brockventures/gotchi/cad/renders/back_iso.png

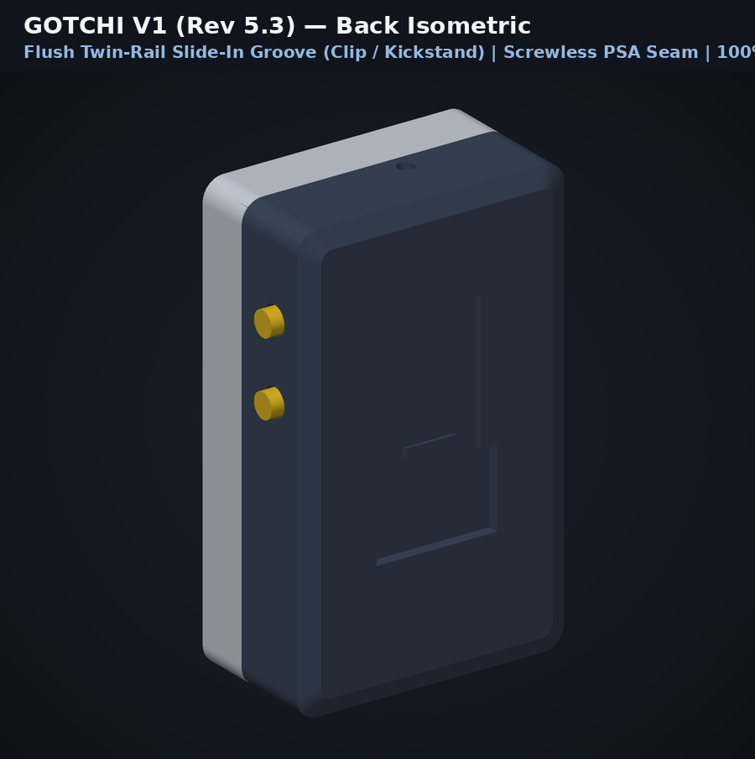
cad/renders/back_iso.png
