brockventures/gotchi/cad/renders/back_layout.png

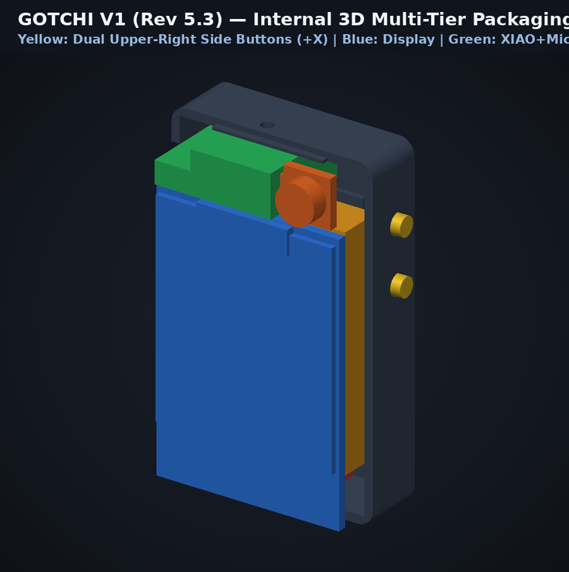
cad/renders/back_layout.png
