brockventures/gotchi/cad/renders/exploded.png

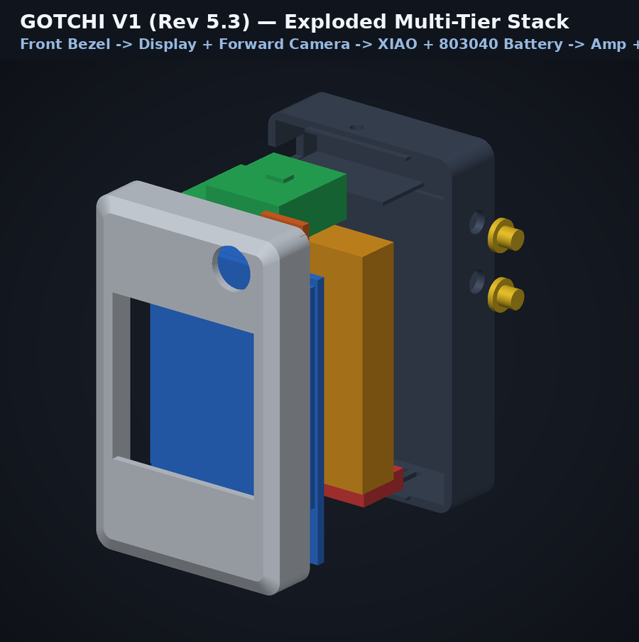
cad/renders/exploded.png
