brockventures/gotchi/cad/renders/front_iso.png

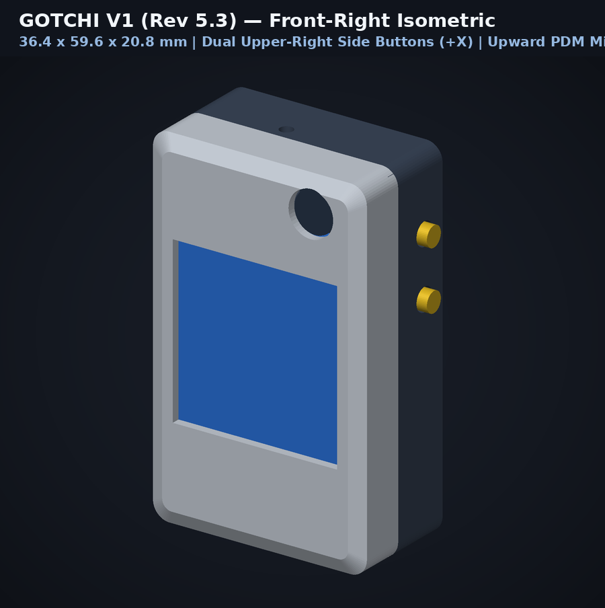
cad/renders/front_iso.png
