brockventures/gotchi/cad/renders/front_straight.png

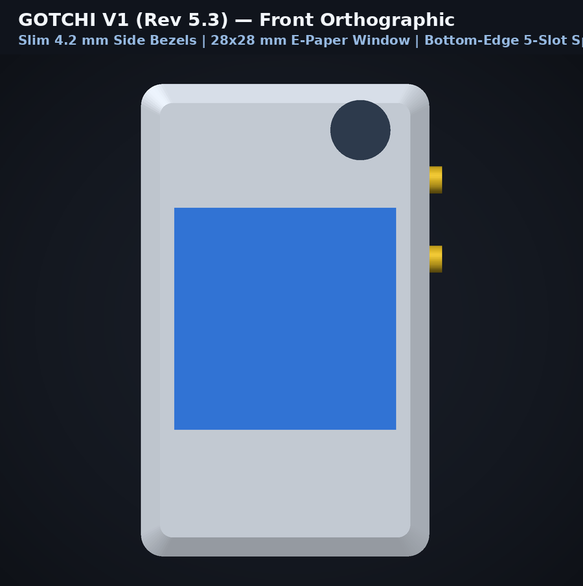
cad/renders/front_straight.png
