brockventures/gotchi/cad/renders/side_labeled.png

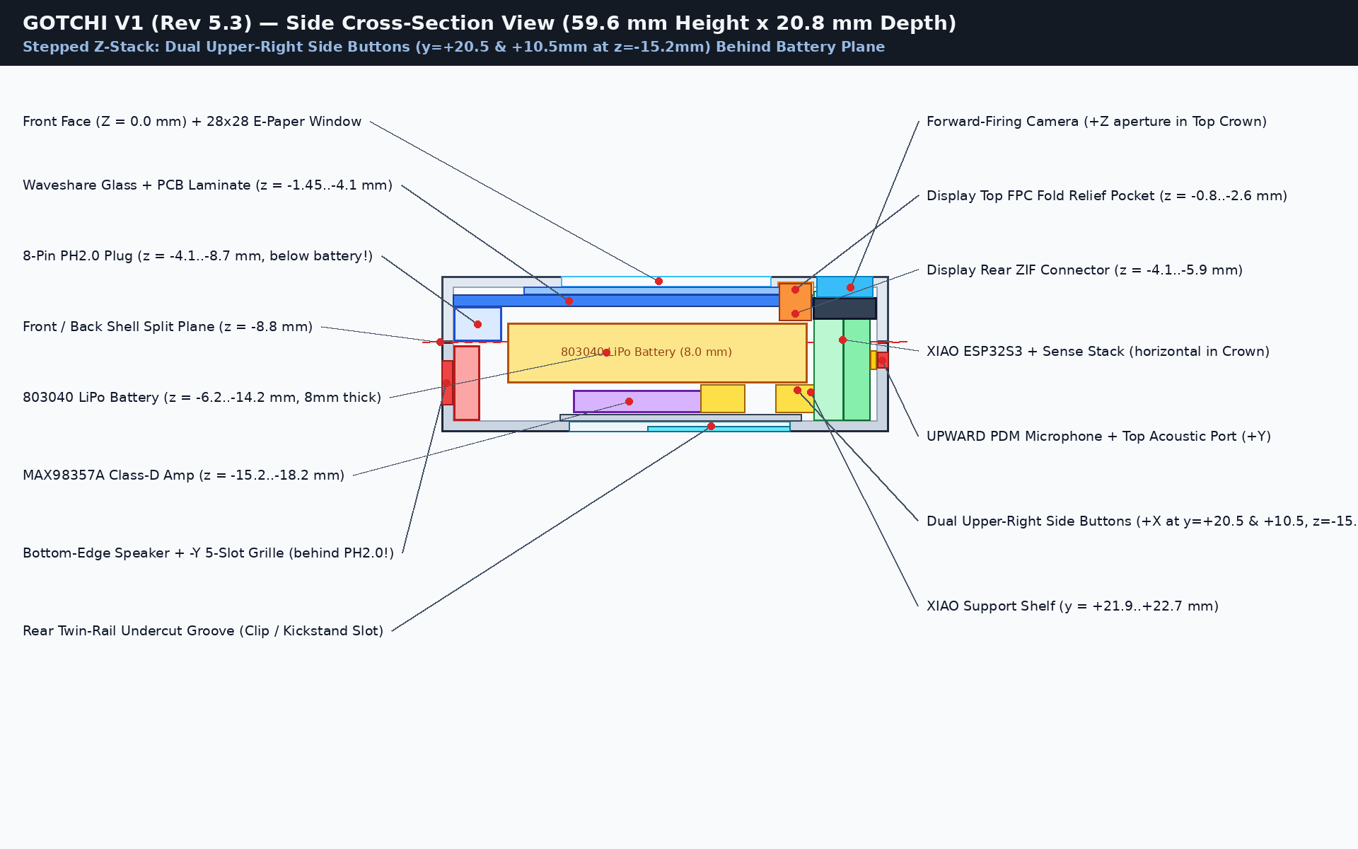
cad/renders/side_labeled.png
