brockventures/gotchi/cad/renders/top_labeled.png

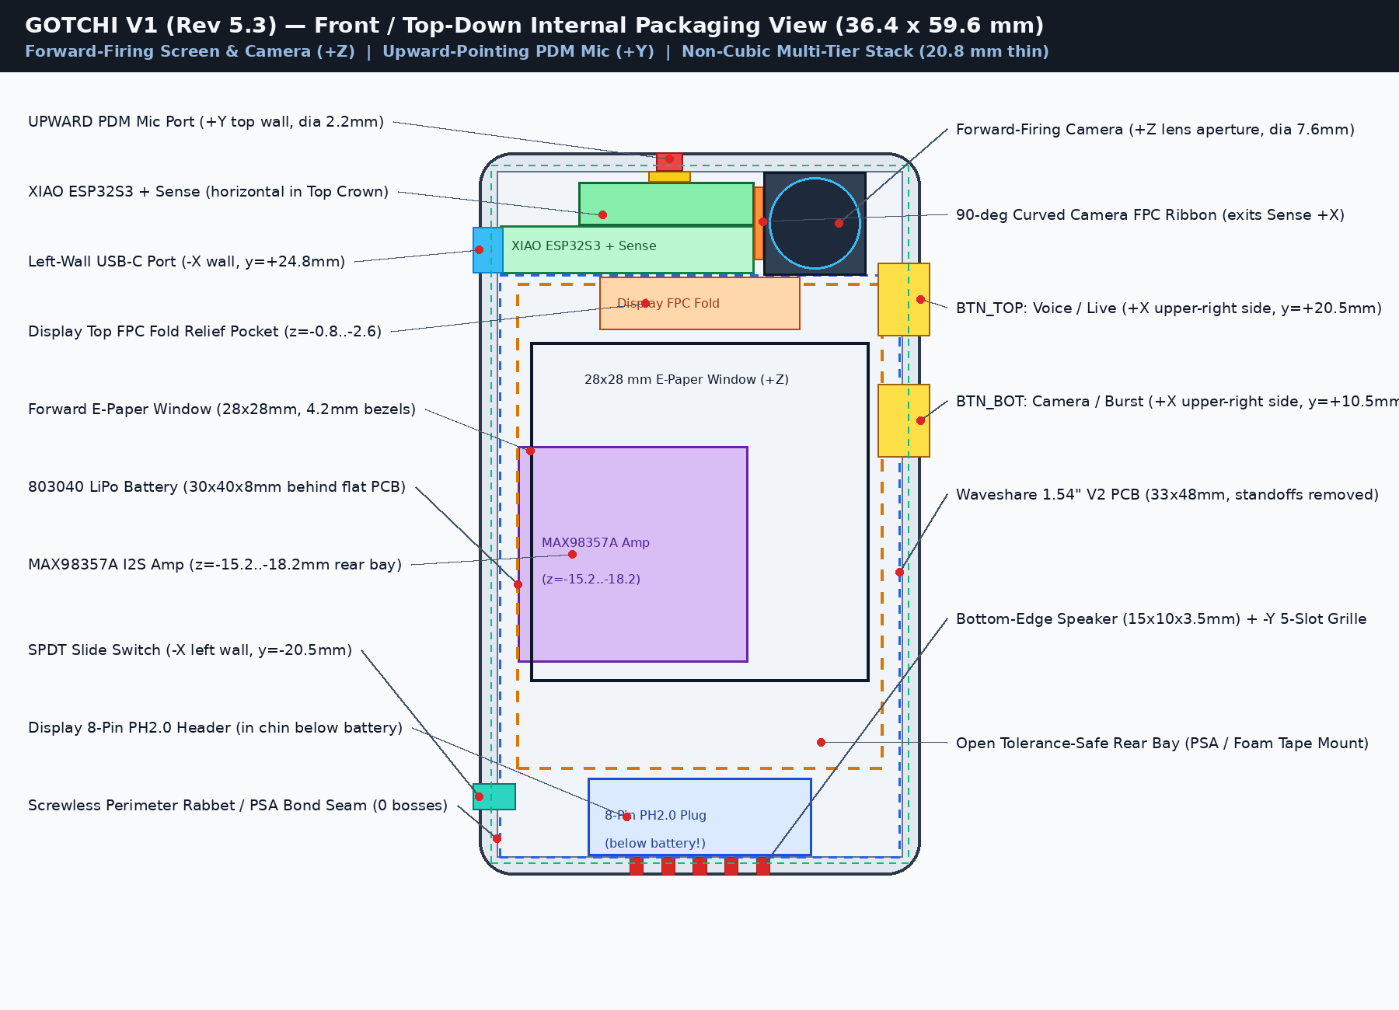
cad/renders/top_labeled.png
