brockventures/gotchi/cad/stl/gotchi_front.stl

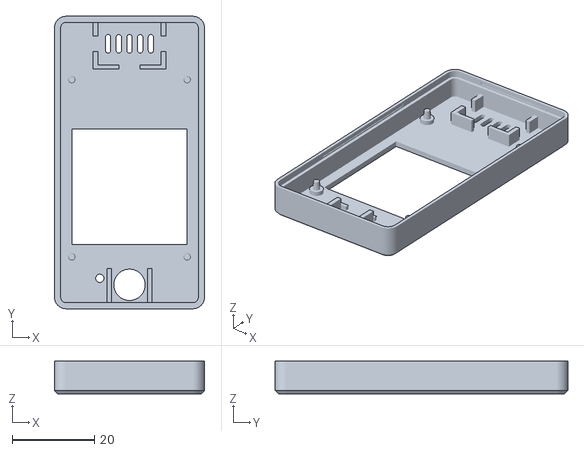
[picture p8: CAD file, 2026-10-24]
cad/stl/gotchi_front.stl
36.4 x 71.0 x 8.00
