brockventures/gotchi/cad/stl/gotchi_hinge_saddle.stl

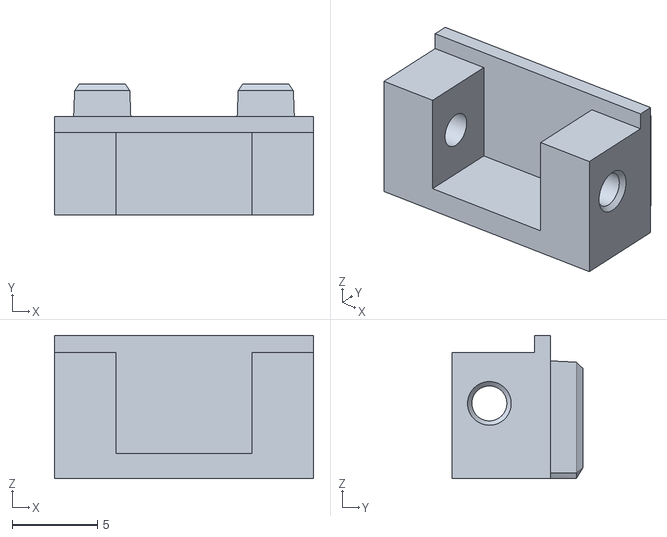
[picture p9: CAD file, 2026-10-24]
cad/stl/gotchi_hinge_saddle.stl
15.2 x 7.70 x 8.42
