brockventures/gotchi/cad/stl/gotchi_clip_stand.stl

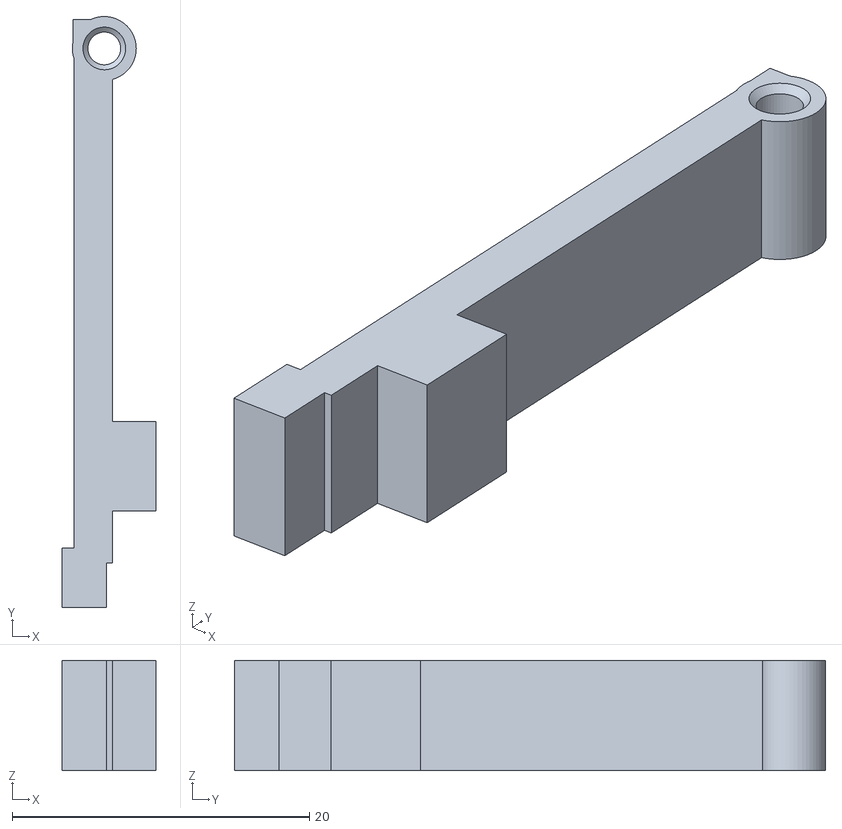
[picture p10: CAD file, 2026-10-24]
cad/stl/gotchi_clip_stand.stl
6.33 x 39.8 x 7.40
