brockventures/gotchi/cad/stl/gotchi_back.stl

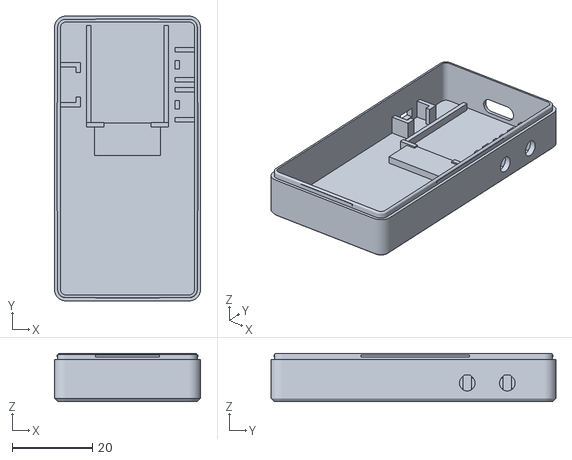
[picture p11: CAD file, 2026-10-24]
cad/stl/gotchi_back.stl
36.4 x 71.0 x 12.0
