brockventures/gotchi/cad/stl/gotchi_clip.stl

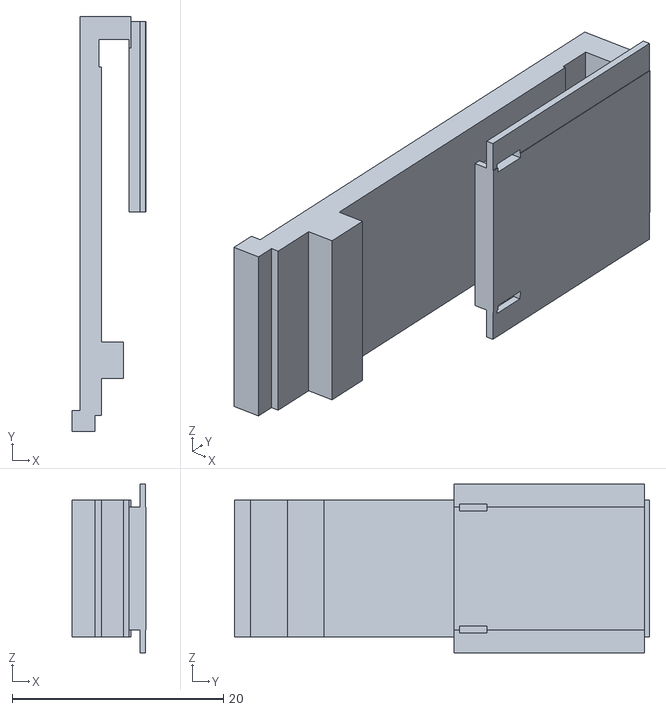
[picture p12: CAD file, 2026-10-23]
cad/stl/gotchi_clip.stl
7.05 x 39.3 x 16.0
