brockventures/gotchi/cad/stl/gotchi_kickstand.stl

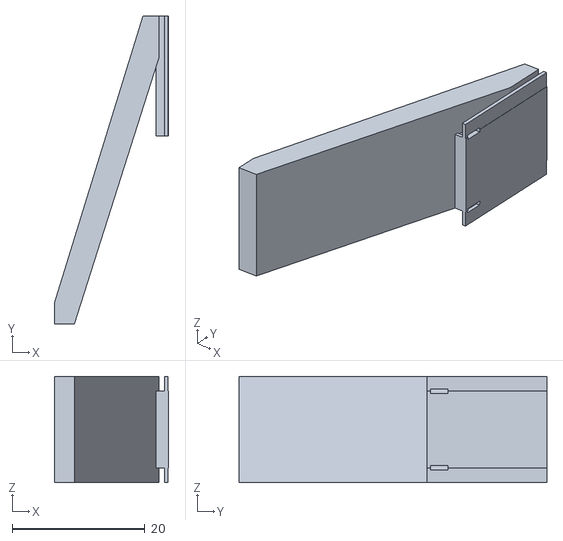
[picture p13: CAD file, 2026-10-23]
cad/stl/gotchi_kickstand.stl
17.1 x 46.3 x 16.0
