brockventures/gotchi/cad/stl/gotchi_button_cap.stl

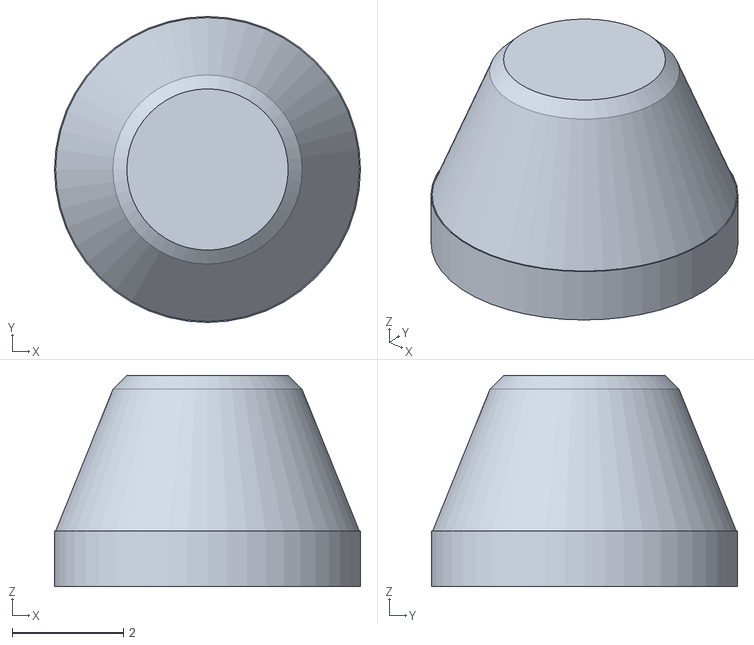
[picture p14: CAD file, 2026-10-23]
cad/stl/gotchi_button_cap.stl
5.50 x 5.50 x 3.80
