brockventures/gotchi/docs/HARDWARE_ASSEMBLY.md

# GOTCHI / SPRITE — Meatspace Hardware Assembly, Pinout & Enclosure Envelope

This document contains the complete physical wiring instructions, GPIO pin multiplexing map, mechanical component dimensions for the multi-part 3D-printed enclosure, and bench bring-up checklist for assembling a V1 GOTCHI unit from the locked 7-item BOM ([`docs/BOM.md`](BOM.md)).

---

## 1. Master GPIO Pinout & Bus Allocation Map

The **XIAO ESP32S3 Sense** uses internal GPIOs (`GPIO10–18`, `38–42`, `47–48`) for its B2B camera and PDM microphone daughterboard, leaving **11 perimeter pins (`D0–D10`)** exposed on the main headers.

The **Waveshare 1.54" E-Paper Module V2 (`SKU 12955` / Amazon `B0728BJTZC`)** includes an **8-pin PH2.0 wire harness** (`VCC`, `GND`, `DIN`, `CLK`, `CS`, `DC`, `RST`, `BUSY`) that wires directly to 6 XIAO perimeter pins plus `3V3`/`GND` (replacing the discontinued Seeed ePaper Breakout), leaving **5 perimeter pins (`D2`, `D4`, `D6`, `D7`, `D9`)** free for I2S audio, tactile buttons, and V2 expansion.

### Complete Pin Allocation Table

| XIAO Pin | ESP32-S3 GPIO | RTC / Deep-Sleep Wake? | V1 Assigned Function | Hardware Connection (Direct Harness / Wire) |
| :--- | :--- | :--- | :--- | :--- |
| **`D0`** | `GPIO 1` | Yes (`RTC_GPIO1`) | **ePaper `RST`** (Reset) | Waveshare 8-pin PH2.0 Harness **`RST`** |
| **`D1`** | `GPIO 2` | Yes (`RTC_GPIO2`) | **ePaper `CS`** (SPI Chip Select) | Waveshare 8-pin PH2.0 Harness **`CS`** |
| **`D2`** | `GPIO 3` | **Yes (`RTC_GPIO3` / `ADC1_CH2`)** | **BTN_TOP (PTT & Wake) + `5V VBUS` Sense** | Momentary `6x6x5mm` switch to `GND` + single `220 kΩ` series resistor from `5V` (`VBUS`) |
| **`D3`** | `GPIO 4` | Yes (`RTC_GPIO4`) | **ePaper `DC`** (Data/Command) | Waveshare 8-pin PH2.0 Harness **`DC`** |
| **`D4`** | `GPIO 5` | **Yes (`RTC_GPIO5` / `ADC1_CH4`)** | **BTN_BOT (Camera Snap) + `VBAT` Fuel Gauge** | Momentary `6x6x5mm` switch to `GND` + `220 kΩ / 220 kΩ` divider from switched `BAT+` to `GND` |
| **`D5`** | `GPIO 6` | Yes (`RTC_GPIO6`) | **ePaper `BUSY`** *(+ V2 `I2C_SCL`)* | Waveshare 8-pin PH2.0 Harness **`BUSY`** |
| **`D6`** | `GPIO 43` | No | **I2S `LRCLK`** (Audio Word Select) | Wire to `MAX98357A` **`LRC`** pin *(UART0 TX at reset)* |
| **`D7`** | `GPIO 44` | No | **I2S `BCLK`** (Audio Bit Clock) | Wire to `MAX98357A` **`BCLK`** pin *(UART0 RX — silent at reset)* |
| **`D8`** | `GPIO 7` | No | **ePaper `SCK`** (SPI Clock) | Waveshare 8-pin PH2.0 Harness **`CLK`** |
| **`D9`** | `GPIO 8` | No | **I2S `DIN`** (Audio Data Out) | Wire to `MAX98357A` **`DIN`** pin *(MISO unused by ePaper)* |
| **`D10`** | `GPIO 9` | No | **ePaper `MOSI`** (SPI Data Out) | Waveshare 8-pin PH2.0 Harness **`DIN`** |
| **`3V3`** | — | — | **3.3V Regulated Rail** | Waveshare 8-pin PH2.0 Harness **`VCC`** (+ optional `MAX98357A VIN`) |
| **`5V`** | — | — | **5V / VBUS Rail** | `MAX98357A VIN` + `220 kΩ` wall-brick sense resistor to `D2` |
| **`GND`** | — | — | **Common Ground** | Waveshare **`GND`**, `MAX98357A` **`GND`**, `BTN_TOP`, `BTN_BOT`, and divider ground legs |
| **`GPIO 0`** | `GPIO 0` | Yes (`RTC_GPIO0`) | **Reserved (`BOOT` Strapping Pad)** | Leave unattached in V1 so holding `BTN_BOT` at power-on never traps the MCU in ROM download mode |
| *Internal* | `GPIO 41` | — | **PDM Mic `CLK`** | Internal via Sense B2B Header |
| *Internal* | `GPIO 42` | — | **PDM Mic `DATA`** | Internal via Sense B2B Header |
| *Internal* | `GPIO 10–18, 38–40, 47–48` | — | **DVP Camera Bus (`OV2640`/`OV3660` or `OV5640`)** | Internal via Sense B2B Header |

> **Strapping & Boot-Glitch Protections (Amos + Zero Audit):**
> 1. **`BTN_BOT` Landed on `D4` (`GPIO 5`) Instead of `GPIO 0`:** `GPIO 0` is the ESP32-S3 ROM bootloader strapping pin. Landing `BTN_BOT` on `D4` (`GPIO 5` / `RTC_GPIO5`) eliminates the risk of entering USB download mode if the button is pressed in a pocket while flipping the power switch, and avoids micro-soldering to the tiny surface-mount `BOOT` pad.
> 2. **Pop-Free Boot on `MAX98357A` (`BCLK` on `D7` / `GPIO 44`):** `D6` (`GPIO 43`) is the ESP32-S3's default `UART0_TX`, which emits brief ROM boot messages at reset, whereas `D7` (`GPIO 44` / `UART0_RX`) is completely silent at boot. Routing **`BCLK` to `D7` (`GPIO 44`)** and **`LRCLK` to `D6` (`GPIO 43`)** ensures the `MAX98357A` sees zero valid bit-clock edges during ROM boot and stays muted until the I2S driver starts.
> 3. **`BTN_TOP` on `D2` (`GPIO 3` Strapping Note):** `GPIO 3` is an optional JTAG-source strapping pin (only evaluated when `EFUSE_STRAP_JTAG_SEL` is burned, which is disabled by default from the factory). Leave `EFUSE_STRAP_JTAG_SEL` unburned (`0`) so holding PTT at power-on has zero effect on USB serial/JTAG.

---

## 2. Step-by-Step Meatspace Assembly Instructions

### Step 1: Camera & Sense Expansion Board Check
1. **Stock V1 Baseline (No Swap Required):** The **XIAO ESP32S3 Sense** ships with its stock camera (`OV2640` / `OV3660`) pre-installed on the Sense expansion board alongside the digital PDM microphone. Stick the included mini heatsink onto the flat backing of the camera module and snap the Sense board onto the top B2B header of the XIAO.
2. **Optional `OV5640` 5MP Autofocus Upgrade (`$11.99`):** If installing the optional `OV5640` camera, unplug the Sense board from the XIAO first, flip up the black locking bail on the 24-pin FPC socket, swap in the `OV5640` ribbon (contacts facing the PCB), press the locking bail flat, and attach the heatsink.
3. Snap the included **U.FL Wi-Fi/BLE flex antenna (`~42 x 12 mm`)** onto the coaxial receptacle on the XIAO and adhere the flat antenna patch strictly along the **inner plastic perimeter wall** of the enclosure. **Never** stick the antenna onto the `803040` LiPo battery's aluminized foil pouch or the metallic rear shield of the Waveshare e-paper panel (which causes `6–12 dB` of near-field capacitive detuning), and keep the U.FL coax away from the speaker magnet and camera FPC ribbon.

### Step 2: Battery Pads & Hardware Power Switch (Bottom of XIAO)
> **SAFETY WARNING:** Never connect or solder the LiPo battery while USB-C is plugged in. Always verify wire polarity (`red = BAT+`, `black = BAT-`) before soldering, and insulate all exposed joints with Kapton tape.

1. Cut the factory 2-pin JST plug off the **`803040` 3.7V 1000mAh LiPo battery (`B0FRFY7KLH`)** one lead at a time (never cut both wires simultaneously with metal cutters) and strip `~3 mm` of insulation.
2. Flip the main **XIAO ESP32-S3** board over to locate the two rectangular solder pads labeled **`BAT+`** and **`BAT-`** on the bottom surface, and tin both pads.
3. Solder the **black (`-`) battery lead** directly to the XIAO **`BAT-`** pad.
4. Solder the **red (`+`) battery lead** to the **center pin (common)** of the **Mini SPDT 3-Pin Slide Switch (`B0FNK8B1YV`)**.
5. Solder a short 30 AWG red wire from **one outer pin** of the slide switch to the XIAO **`BAT+`** pad. (Sliding the switch toward that outer pin turns the unit ON and enables USB-C LiPo charging; sliding it away completely disconnects the battery).
6. Apply a strip of **Kapton tape** over the bottom of the XIAO board to insulate the solder pads.

### Step 3: Wiring the Waveshare 1.54" E-Paper Module V2 (`SKU 12955` / `B0728BJTZC`)
Plug the included **8-pin PH2.0 connector** into the back of the Waveshare 1.54" E-Paper Module V2 PCB and solder/connect the 8 leads directly to the XIAO ESP32S3:
- **`VCC`** -> XIAO **`3V3`**
- **`GND`** -> XIAO **`GND`**
- **`DIN` (MOSI)** -> XIAO **`D10` (`GPIO 9`)**
- **`CLK` (SCK)** -> XIAO **`D8` (`GPIO 7`)**
- **`CS`** -> XIAO **`D1` (`GPIO 2`)**
- **`DC`** -> XIAO **`D3` (`GPIO 4`)**
- **`RST`** -> XIAO **`D0` (`GPIO 1`)**
- **`BUSY`** -> XIAO **`D5` (`GPIO 6`)**

### Step 4: Wiring the `MAX98357A` I2S Audio Amplifier (`B0DPJRLMDJ`) & Speaker (`B0D7S8FFKY`)
Wire the **`MAX98357A`** breakout to the XIAO with 30 AWG silicone wire:
- **`MAX98357A VIN`** -> XIAO **`5V`** (or **`3V3`** for lower peak battery current)
- **`MAX98357A GND`** -> XIAO **`GND`**
- **`MAX98357A BCLK`** -> XIAO **`D7` (`GPIO 44`)** *(Silent `UART0_RX` at boot — prevents ROM serial boot pop)*
- **`MAX98357A LRC`** -> XIAO **`D6` (`GPIO 43`)**
- **`MAX98357A DIN`** -> XIAO **`D9` (`GPIO 8`)**
- **`MAX98357A SD` (Shutdown)** -> Leave floating (internal pull-up keeps amp enabled in mono `(L+R)/2` mode; automatically enters `<1 µA` hardware shutdown whenever the ESP32-S3 stops the I2S clock).
- Connect or solder the **1W 8Ω Mini Cavity Speaker (`B0D7S8FFKY`)** leads to the `+` and `-` audio output terminals on the `MAX98357A`. **Twist the `+` and `-` speaker wires into a tight twisted pair (`~2–3 twists/cm`)** and trim lead length to **`<= 40–50 mm`** so the `MAX98357A`'s filterless Class-D switching edges (`~300 kHz`) cancel out rather than radiating broadband harmonics into the 2.4 GHz antenna.

### Step 5: Wiring the Tactile Push Buttons (`6x6x5mm`, `B07VSNN9S2`)
1. **Top Button (`BTN_TOP` — Push-to-Talk & Deep-Sleep Wake):**
   - Wire Pin 1 of the tactile switch to XIAO **`D2` (`GPIO 3` / `RTC_GPIO3`)**.
   - Wire Pin 2 of the tactile switch to **`GND`**.
2. **Bottom Button (`BTN_BOT` — Camera Snap / 5-Frame Burst):**
   - Wire Pin 1 of the tactile switch directly to XIAO **`D4` (`GPIO 5` / `RTC_GPIO5`)**. *(Never wire to `GPIO 0`).*
   - Wire Pin 2 of the tactile switch to **`GND`**.

### Step 6: Wiring the V1 Battery Fuel Gauge (`D4`) & Wall-Brick Power Sense (`D2`) (3x `220 kΩ` Resistors)
Because the XIAO ESP32S3 does not route `VBUS` (`5V`) or `BAT+` internally to any GPIO, V1 uses **3x `220 kΩ` (`1/4W 1%`) resistors** (all three are the exact same `220 kΩ` value) sleeved in heat-shrink tubing to multiplex battery voltage and wall-brick detection onto `D4` and `D2`:

1. **LiPo Battery Fuel Gauge Divider on `D4` (`GPIO 5` / `ADC1_CH4` — 2x `220 kΩ`):**
   - Solder one **`220 kΩ` resistor** between the switched **`BAT+` outer terminal** on the SPDT power switch and XIAO **`D4`**.
   - Solder a second **`220 kΩ` resistor** between XIAO **`D4`** and **`GND`** (you can solder it directly across the two legs of `BTN_BOT`).
   - *How it works:* Normal operation keeps `D4`'s internal `45 kΩ` pull-up enabled so `D4` idles at `>= 2.82 V` (`> 2.475 V` `V_IH_min`). Once per second when idle, firmware takes a `200 µs` high-Z ADC sample (`V_BAT / 2` = `1.65V–2.10V` for a `3.30V–4.20V` LiPo, drawing `<9 µA` when switched ON and `0 µA` when switched OFF) to compute `0–100%` battery state-of-charge.
2. **Wall-Brick (`5V VBUS`) Sense on `D2` (`GPIO 3` / `ADC1_CH2` — 1x `220 kΩ`):**
   - Solder the third **`220 kΩ` resistor** between XIAO **`5V`** (`VBUS`) and XIAO **`D2`** *(no external ground resistor is used on `D2`)*.
   - *How it works:* During normal operation (`INPUT_PULLUP` `45 kΩ` to `3.3V`), even if the `5V` rail is pulled to `0V` by the `MAX98357A` load when running on battery, `D2` idles at `3.3V × 220 / (45 + 220) = 2.74 V` (or `3.30 V` if `5V` floats) — safely above the ESP32-S3's `2.475 V` (`0.75 × VDD`) `V_IH` minimum so `BTN_TOP` digital reads and `ext0` deep-sleep wake work reliably. Once per second when idle, firmware briefly enables `INPUT_PULLDOWN` (`45 kΩ` to `GND`) for `200 µs`: when a 5V USB-C wall brick or computer is plugged in, `D2` reads `5.0V × 45 / (220 + 45) ≈ 849 mV` (`>= 450 mV` threshold) vs. `0 mV` on battery, enabling `preroll_mode: "usb_host"` and the on-screen charging indicator (`+`).

### Step 7: RF Desense & Internal Harness Routing Rules (2.4 GHz Wi-Fi / BLE)
Inside the compact `54 × 44 mm` enclosure, follow these three physical routing rules to prevent 2.4 GHz receiver desense and near-field antenna detuning:
1. **LiPo Foil & E-Paper Shield Keep-Out (`6–12 dB` Detuning Prevention):**
   - Adhere the `42 × 12 mm` U.FL flex antenna patch flat against the **outer PLA/PETG perimeter wall** with **`>= 5 mm` air gap** from both the `803040` LiPo battery's aluminized pouch and the metallic rear shield of the Waveshare 1.54" e-paper module. Never fold, crease, or trim the copper radiating element.
2. **Twisted-Pair Filterless Class-D Speaker Leads (`MAX98357A` EMI Suppression):**
   - Because the `MAX98357A` uses a filterless Class-D H-bridge (`~300 kHz` PWM with fast rising/falling edges), keep the speaker leads **`<= 40–50 mm`** and twisted at **`~2–3 twists/cm`** all the way from the amp terminals to the `1510` speaker cavity.
3. **High-Speed Digital Bus Separation (`I2S`, `SPI`, and `20 MHz` Camera `XCLK`):**
   - Dress the thin coaxial lead from the XIAO U.FL jack along the opposite edge of the board from the `D6/D7/D9` I2S clock bundle (`BCLK`/`LRCLK`), the `D8/D10` e-paper SPI harness, and the 24-pin camera FPC ribbon (`20 MHz XCLK` / PCLK).

---

## 3. Mechanical Component Envelope (For Multi-Part Blender / CAD Case)

Reference dimensions for the locked 7-item V1 BOM (`cad/` multi-part openable shell):

| # | Component | Nominal Dimensions (`L x W x H`) | Enclosure Cutout & Mounting Notes |
| :--- | :--- | :--- | :--- |
| **1** | **XIAO ESP32S3 + Sense Stack** | `21.0 x 17.8 x ~15.0 mm` | `USB-C` receptacle (`9.0 x 3.4 mm` opening) on bottom edge; top-port MEMS PDM mic sits on the top face of the Sense expansion board adjacent to the camera FPC header (faces the same direction as the camera lens, so a `Ø 2.0 mm` pinhole next to the `~8.5 x 8.5 mm` camera cutout or a shared relief channel works cleanly); `U.FL` flex antenna patch (`~42 x 12 mm`). |
| **2** | **Waveshare 1.54" E-Paper V2 (`SKU 12955`)** | **`48.0 x 33.0 x ~2.8 mm`** *(+ `~5.5 mm` rear PH2.0 header)* | Active viewing bezel opening: **`27.6 x 27.6 mm`** (`200x200` px). 4x **`M2` (`Ø 2.0 mm`)** corner mounting holes (`~43.0 x 28.0 mm` hole centers). |
| **3** | **MAX98357A I2S Amp (`B0DPJRLMDJ`)** | `~19.0 x 17.8 x 3.0 mm` | Internal tray or siderib slot; 2x `M2` mounting holes. |
| **4** | **1W 8Ω Cavity Speaker (`B0D7S8FFKY`)** | **`15.0 x 10.0 x 3.5 mm`** (`1510` cavity, allow `16.0 x 11.0 x 4.5 mm` pocket) | Enclosed resonant micro-speaker w/ JST-PH1.25 leads; place sound grille slots facing outward. |
| **5** | **`803040` 1000mAh LiPo (`B0FRFY7KLH`)** | **`40.0 x 30.0 x 8.0 mm`** *(design bay **`42.0 x 32.0 x 9.0 mm`**)* | Flat rear compartment in the back shell half with `1.0 mm` swell clearance and wire exit channel. |
| **6** | **2x Tactile Buttons (`B07VSNN9S2`)** | `6.0 x 6.0 x 5.0 mm` (`3.5 mm` base + `1.5 mm` stem) | Side-edge cradle for `BTN_TOP` (PTT) and `BTN_BOT` (Mode/Snap) with captive button caps or compliant flex paddles. |
| **7** | **Mini SPDT Slide Switch (`B0FNK8B1YV`)** | `~8.5 x 3.5 x 4.0 mm` (`2.0 mm` slider travel) | Recessed perimeter slot (`~4.5 x 2.0 mm` window) so the power switch cannot flip accidentally in a pocket. |

---

## 4. First-Power & Smoke-Test Checklist

1. **Continuity & Short Check:** With the power switch **OFF** and USB-C unplugged, use a multimeter to verify there is no short between `3V3` and `GND` or `5V` and `GND`.
2. **USB-C Bring-Up:** Plug a USB-C data cable into your workstation, flip the slide switch **ON**, and verify `/dev/ttyACM0` (Linux) or `/dev/cu.usbmodem*` (macOS) enumerates.
3. **Automated Hardware & RF Desense Self-Test:** Once V1 firmware is flashed, send `{"cmd": "self_test"}` over USB serial (`115200` baud) or HTTP (`POST /api/rpc`) and confirm all subsystems and RF checks pass:
   - `speaker`: Plays an 880 Hz test tone on the `MAX98357A`.
   - `mic`: Samples non-zero RMS audio energy on the PDM mic (`GPIO41`/`42`).
   - `camera`: Initializes the stock `OV2640`/`OV3660` (or optional `OV5640` AF) camera (`camera_pid != 0`) and captures a valid test JPEG frame (`camera_frame_bytes > 0`).
   - `display`: Verifies `epd_busy_clear: true` and renders the 200x200 sprite on the Waveshare 1.54" V2 e-paper panel.
   - `wifi_rssi_dbm` (`wifi_rssi_idle_dbm` vs. `wifi_rssi_active_dbm`): Measures baseline idle 2.4 GHz Wi-Fi RSSI against active RSSI sampled while the `MAX98357A` Class-D speaker tone and camera DVP capture run simultaneously. Confirm **`wifi_rssi_drop_db <= 2` (`rf_desense_warn: false`)**. If `wifi_rssi_drop_db > 2 dB`, move the U.FL flex antenna further from the LiPo/e-paper shield or tighten the speaker wire twist before closing the case.
