brockventures/gotchi/cad/renders/v3_build_preview.png

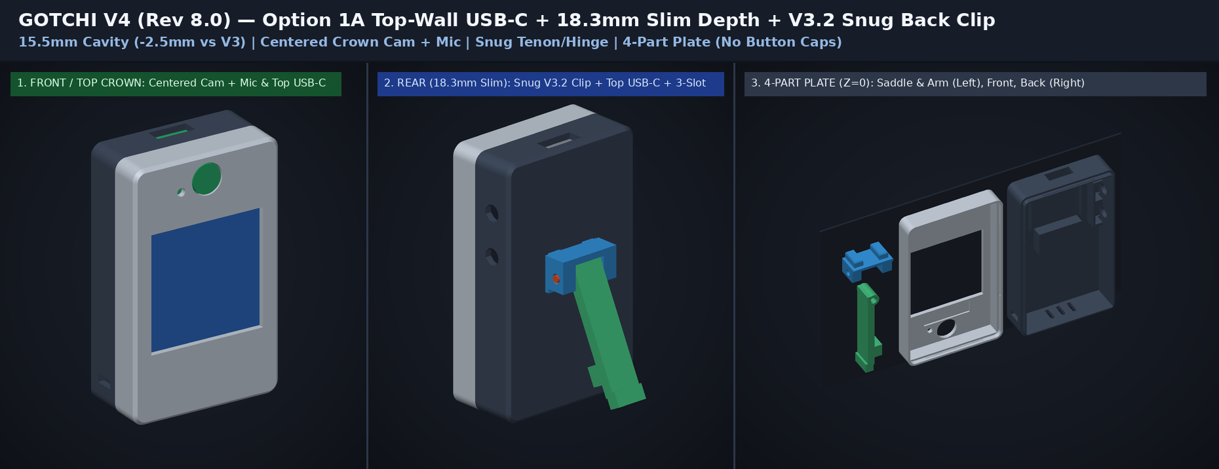
cad/renders/v3_build_preview.png
