brockventures/gotchi/firmware/include/zero_skin_bitmap.h

#pragma once
#include <Arduino.h>
#include <pgmspace.h>

// 196x134 1-bit Atkinson-dithered Zero portraits (bit=1 is WHITE pixel on BLACK background)
static constexpr int ZERO_PORTRAIT_W = 196;
static constexpr int ZERO_PORTRAIT_H = 134;

const uint8_t ZERO_IDLE_PORTRAIT_196x134[] PROGMEM = {
    0x00, 0x00, 0x00, 0x00, 0x00, 0x00, 0x00, 0x00, 0x00, 0x00, 0x00, 0x12, 0x49, 0x24, 0x84, 0x00, 0x00, 0x00, 0x00, 0x00, 0x00, 0x00, 0x00, 0x00, 0x00, 0x00, 0x00, 0x00, 0x00, 0x00, 0x00, 0x00, 0x00, 0x00, 0x09, 0x36, 0xc9, 0x66, 0xd9, 0x33, 0x6c, 0x90, 0x00, 0x00, 0x00, 0x00, 0x00, 0x00, 0x00, 0x00, 0x00, 0x00, 0x00, 0x00, 0x00, 0x00, 0x00, 0x00, 0x09, 0x24, 0xc4, 0xbf, 0xff, 0xff, 0xf9, 0x22, 0x46, 0x48, 0x00, 0x00, 0x00, 0x00, 0x00, 0x00, 0x00, 0x00, 0x00, 0x00, 0x00, 0x00, 0x00, 0x00, 0x01, 0x21, 0x26, 0x5b, 0xff, 0xff, 0xff, 0xff, 0xdb, 0x48, 0x82, 0x00, 0x00, 0x00, 0x00, 0x00, 0x00, 0x00, 0x00, 0x00, 0x00, 0x00, 0x00, 0x00, 0x00, 0x08, 0x04, 0x99, 0x7f, 0xfe, 0x40, 0x02, 0xff, 0xfd, 0x32, 0x30, 0x90, 0x00, 0x00, 0x00, 0x00, 0x00, 0x00, 0x00, 0x00, 0x00, 0x00, 0x00, 0x00, 0x00, 0x42, 0x52, 0x4d, 0xff, 0x00, 0x00, 0x00, 0x00, 0xff, 0xed, 0x84, 0x04, 0x00, 0x00, 0x00, 0x00, 0x00, 0x00, 0x00, 0x00, 0x00, 0x00, 0x00, 0x00, 0x01, 0x10, 0x4b, 0x7f, 0xe0, 0x00, 0x00, 0x00, 0x00, 0x07, 0xfc, 0xd3, 0x21, 0x00, 0x00, 0x00, 0x00, 0x00, 0x00, 0x00, 0x00, 0x00, 0x00, 0x00, 0x00, 0x04, 0x05, 0x29, 0xff, 0x00, 0x01, 0xff, 0xfe, 0x00, 0x00, 0x7f, 0x98, 0x88, 0x40, 0x00, 0x00, 0x00, 0x00, 0x00, 0x00, 0x00, 0x00, 0x00, 0x00, 0x00, 0x10, 0x41, 0x27, 0xf0, 0x00, 0xff, 0xff, 0xff, 0xff, 0x00, 0x07, 0xf6, 0x42, 0x10, 0x00, 0x00, 0x00, 0x00, 0x00, 0x00, 0x00, 0x00, 0x00, 0x00, 0x00, 0x41, 0x19, 0xbf, 0x80, 0x0f, 0xff, 0xff, 0xff, 0xff, 0xf8, 0x00, 0xfd, 0x50, 0x84, 0x00, 0x00, 0x00, 0x00, 0x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
};

const uint8_t ZERO_BASE_PORTRAIT_196x134[] PROGMEM = {
    0x00, 0x00, 0x00, 0x00, 0x00, 0x00, 0x00, 0x00, 0x00, 0x00, 0x00, 0x12, 0x49, 0x24, 0x84, 0x00, 0x00, 0x00, 0x00, 0x00, 0x00, 0x00, 0x00, 0x00, 0x00, 0x00, 0x00, 0x00, 0x00, 0x00, 0x00, 0x00, 0x00, 0x00, 0x09, 0x36, 0xc9, 0x66, 0xd9, 0x33, 0x6c, 0x90, 0x00, 0x00, 0x00, 0x00, 0x00, 0x00, 0x00, 0x00, 0x00, 0x00, 0x00, 0x00, 0x00, 0x00, 0x00, 0x00, 0x09, 0x24, 0xc4, 0xbf, 0xff, 0xff, 0xf9, 0x22, 0x46, 0x48, 0x00, 0x00, 0x00, 0x00, 0x00, 0x00, 0x00, 0x00, 0x00, 0x00, 0x00, 0x00, 0x00, 0x00, 0x01, 0x21, 0x26, 0x5b, 0xff, 0xff, 0xff, 0xff, 0xdb, 0x48, 0x82, 0x00, 0x00, 0x00, 0x00, 0x00, 0x00, 0x00, 0x00, 0x00, 0x00, 0x00, 0x00, 0x00, 0x00, 0x08, 0x04, 0x99, 0x7f, 0xfe, 0x40, 0x02, 0xff, 0xfd, 0x32, 0x30, 0x90, 0x00, 0x00, 0x00, 0x00, 0x00, 0x00, 0x00, 0x00, 0x00, 0x00, 0x00, 0x00, 0x00, 0x42, 0x52, 0x4d, 0xff, 0x00, 0x00, 0x00, 0x00, 0xff, 0xed, 0x84, 0x04, 0x00, 0x00, 0x00, 0x00, 0x00, 0x00, 0x00, 0x00, 0x00, 0x00, 0x00, 0x00, 0x01, 0x10, 0x4b, 0x7f, 0xe0, 0x00, 0x00, 0x00, 0x00, 0x07, 0xfc, 0xd3, 0x21, 0x00, 0x00, 0x00, 0x00, 0x00, 0x00, 0x00, 0x00, 0x00, 0x00, 0x00, 0x00, 0x04, 0x05, 0x29, 0xff, 0x00, 0x01, 0xff, 0xfe, 0x00, 0x00, 0x7f, 0x98, 0x88, 0x40, 0x00, 0x00, 0x00, 0x00, 0x00, 0x00, 0x00, 0x00, 0x00, 0x00, 0x00, 0x10, 0x41, 0x27, 0xf0, 0x00, 0xff, 0xff, 0xff, 0xff, 0x00, 0x07, 0xf6, 0x42, 0x10, 0x00, 0x00, 0x00, 0x00, 0x00, 0x00, 0x00, 0x00, 0x00, 0x00, 0x00, 0x41, 0x19, 0xbf, 0x80, 0x0f, 0xff, 0xff, 0xff, 0xff, 0xf8, 0x00, 0xfd, 0x50, 0x84, 0x00, 0x00, 0x00, 0x00, 0x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
};
