brockventures/gotchi/(commit log)

2026-10-18 Initial commit: GOTCHI / SPRITE architecture, BOM, and agent-configurable spec
2026-10-18 Separate decided baseline from open proposals; restore BLE phone relay & drop unagreed 1-bit lock
2026-10-18 Keep shared phone internet requirement in baseline; move BLE relay vs hotspot mechanics to open proposals
2026-10-19 Add locked V1 BOM, meatspace hardware assembly guide, architecture spec, software task board, and updated README/AGENTS.md
2026-10-19 docs(bom): update BOM with live verified Seeed + Amazon prices and drop discontinued ePaper breakout
2026-10-19 docs(bom): lock 1-unit per-builder live BOM, verify B0728BJTZC=SKU 12955, and remove Seeed breakout
2026-10-19 docs: sync all repo specs to locked 7-item V1 BOM and add mechanical case dimensions
2026-10-19 docs(assembly): update B0D7S8FFKY speaker to 15x10x3.5mm and note Sense PDM mic face
2026-10-19 cad: V1 two-part printable case (Blender script, STLs, renders)
    Parametric Blender 4.0.2 script that builds the front half, back half and
    button cap from one parameter dict, then exports print-oriented STLs, a
    .blend of the assembled design and three Cycles previews.
    Run headless: blender -b --python cad/build_case.py -- --out cad
    Notes on solver/tessellation choices (no parameter values changed):
    - cylinders rotated half a segment to avoid tangent contact with walls
    - boss top embedded 0.01 mm into front wall (coplanar face gave NM edges)
    - each hole cutter is its own boolean (combined operand corrupted front)
    [gotchi_back.stl, gotchi_button_cap.stl, gotchi_case.blend, gotchi_front.stl]
2026-10-19 docs(agents): point cad/ layout entry at V1 case README and run command
    Also ignore Blender's cad/*.blend1 backup written on re-runs.
2026-10-19 cad: exploded view moves only the back half; three part lines
    - exploded.png: placeholders stay at assembled coordinates; only the back
    half moves -35 Z. Camera moved below the front rim so placeholders are
    not occluded.
    - build_case.py: drop the duplicate (print) lines so the run prints exactly
    three part lines. Print copies are rigid transforms, so the check is
    unchanged.
    - README: cylinder half-segment rotation described as pre-emptive, not
    shown necessary. Combined-hole defect described as observed, cause not
    isolated.
    [gotchi_case.blend]
2026-10-19 cad: V1 case rev 2, 9.0 mm display bay and PDM mic port
    - disp_d 7.0 -> 9.0; front half z 0..-11, back half z -11..-29 (D_out 29.0)
    - btn_cz and sw_cz -16 -> -18 so buttons, sockets and switch keep their place
    - Back-half z values shift -2.0; pilot holes measured 6.0 from z=-11
    - Mic port: own boolean cutter, d 2.0 at (6.0, -24.0), through back wall only
    - Regenerated STLs, gotchi_case.blend and renders
    Parts: front 38x72x11 nonmanifold=0; back 38x72x18 nonmanifold=0;
    button_cap 5.49x5.49x4.00 nonmanifold=0.
    [gotchi_back.stl, gotchi_case.blend, gotchi_front.stl]
2026-10-19 cad: README for rev 2 (params, collisions, fit-test items)
2026-10-19 cad rev 3: XIAO behind the display, USB-C slot in back half, flat split rim, readable renders
    [gotchi_back.stl, gotchi_case.blend, gotchi_front.stl]
2026-10-19 cad: labelled top-down and side section views
2026-10-19 feat(cad): Rev 4 slim forward-firing multi-tier case (36.4x60.2x20.8mm, upward mic, non-cubic 3D stack)
    [gotchi_back.stl, gotchi_button_cap.stl, gotchi_case.blend, gotchi_front.stl]
2026-10-19 fix(cad): replace matplotlib Painter's algorithm with true per-pixel Z-buffer 2x SSAA renderer
2026-10-19 feat(cad): add flush rear twin-rail slide-in groove + spring clip & 20-deg kickstand STLs (Rev 4.1)
    [gotchi_back.stl, gotchi_clip.stl, gotchi_kickstand.stl]
2026-10-19 feat(software): scaffold ESP32-S3 firmware, 200x200 e-paper sprite engine & Pi Zero W POC harness
    [partitions_8mb_ota.csv]
2026-10-19 feat(firmware): e-paper renderer and refresh policy (T2.6)
    Port poc/gotchi_poc.py to C++ for the Waveshare 1.54" V2 (SSD1681):
    - epd_panel.{h,cpp}: EpdPanel wraps GxEPD2_154_D67 (SPI on the 8-pin
    harness pins). Refresh policy matches RefreshTracker: full on first
    frame, after 8 partials, or after 15 min; full recovery after a BUSY
    timeout. Partial/full counters and first-frame flag live in RTC memory
    so they survive deep sleep. epdWaitBusy() is moved here from main.cpp.
    - ui_state.h: GotchiUIState mirroring the Python dataclass, UiState enum
    (scoped, since BUSY/ERROR collide with ESP-IDF ROM declarations), and
    uiStateFromString (unknown -> IDLE).
    - sprite_render.cpp: renderFrame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
    [epd_panel.cpp, epd_panel.h, main.cpp, sprite_render.cpp, ui_state.h]
2026-10-19 docs(agents): correct PDM mic pins and drop D4 wake-pin claim
    - PDM mic is CLK = GPIO42, DATA = GPIO41, matching pins.h and Seeed's
    I2S.setPinsPdmRx(42, 41) example.
    - Remove the bullet calling D4 a reserved wake/I2C pin. D4 is BTN_BOT.
2026-10-19 fix(firmware): show SR/bytes caption only without reply or transcript
    Matches the Python reference, which prints the SR/B diagnostic line only
    when both reply and transcript are empty.
    [sprite_render.cpp]
2026-10-19 fix(firmware): disable GxEPD2 serial diagnostics so they do not interleave with JSON-RPC
    init(0, ...) keeps the same signature (bitrate 0 = diagnostics off).
    [epd_panel.cpp]
2026-10-19 feat(firmware): C++ HALs for T2.3 PDM mic, T2.4 MAX98357A speaker, T2.5 camera & T2.7 Soft-AP portal (#4)
    * feat(firmware): add modular C++ HALs for T2.3 PDM mic, T2.4 MAX98357A I2S TX, T2.5 camera & T2.7 portal
    * feat(firmware): wire T2.3-T2.7 HALs into main.cpp and mark Epic 2 tasks complete
    ---------
2026-10-19 feat(firmware): Mirrormere voice client and push-to-talk loop (T3.1)
    - voice_client: multipart WAV upload over WiFiClient to
    /api/voice/interact, streaming SSE parser with 256 KB PSRAM line
    buffer, de-chunking for Transfer-Encoding: chunked, 60 s idle timeout.
    `sentence.audio_b64` (and legacy `audio_chunk.data`) plays as it
    arrives via playBase64PcmChunk.
    - main: voice_url config key (default mirrormere.local:9098; set the
    LAN address per device via set_config). Join Wi-Fi at boot (15 s),
    OFFLINE sprite if not connected. Replace loop() with a PTT loop:
    30 ms debounce, 15 s cap, TOO SHORT gate, interact() with sprite
    redraw per state change.
    - Fix inherited build error: gotchi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
    [main.cpp, voice_client.cpp, voice_client.h]
2026-10-19 feat(t3.2): add per-device bearer token auth, skin config & Core 0 PTT mic task
2026-10-19 fix(firmware): define GotchiConfig.skin/bearer_token, constantTimeEquals, collectHeaders & deterministic task join
    [audio_hal.cpp, main.cpp]
2026-10-19 feat(firmware): add hybrid tap-to-talk, barge-in, 3s camera staging, and configurable timings
2026-10-19 feat(firmware): align button layout with PRD F13/F14/F19/F20/F21
2026-10-19 feat(cad): move both buttons to upper-right side wall (+X) and verify 0.00 mm3 switch clearance
    [gotchi_back.stl]
2026-10-19 feat(cad): Rev 5.1 screwless PSA/rabbet seam, open tolerance-safe bays, shifted speaker/camera, 59.6mm Y
    [gotchi_back.stl, gotchi_clip.stl, gotchi_front.stl, gotchi_kickstand.stl]
2026-10-19 feat(cad): Rev 5.2 front-chin acoustic waveguide & +Z front-firing speaker grille, sealed back wall
    [gotchi_back.stl, gotchi_front.stl]
2026-10-19 feat(cad): Rev 5.3 bottom-edge (-Y) direct-firing speaker grille behind PH2.0 plug
    [gotchi_back.stl, gotchi_front.stl]
2026-10-19 fix(review): address Cycle #1 & #2 review findings (0-byte UploadFile guard, audio_b64 SSE, standalone snapshot protocol) (#25)
    [main.cpp, voice_client.cpp]
2026-10-19 fix(voice): track wrote_part across burst frames & add live Mirrormere rollout task (#26)
    [voice_client.cpp]
2026-10-19 feat(live): Go Live bidirectional streaming client & gateway relay (Closes #20) (#29)
2026-10-19 fix(review): address PR #27, #28, and #29 review findings across firmware, gateways, and TASKS.md (#30)
    [audio_hal.cpp, audio_hal.h, main.cpp]
2026-10-19 fix(fw,ble,gateway): rename DISABLED macro collision, add setuptools packages, mount live routes, and harden BLE reassembler (#32)
    [ble_framing.h, main.cpp]
2026-10-19 feat(android): headless Android BLE-to-Tailscale foreground relay service & TASKS.md cleanup (Closes #22) (#33)
2026-10-19 feat(fw,backend): ESP32-S3 BLE GATT peripheral, DiscordVoiceSink, and user-customizable LLM config (T3.3/T3.4/T4.1) (#34)
2026-10-19 docs(tasks): refine Epic 6 per review, scope Go Live AEC/barge-in (T6.1), and add V2.1 LED glow (#44) (#45)
2026-10-19 docs(tasks): add V2.2 OV5640 5MP AF camera upgrade and V2 hardware backlog (#49)
2026-10-19 feat(fw,docs): promote V1 ADC battery fuel gauge (D4) and wall-brick 5V sense (D2) to V1 PRD (#50)
2026-10-19 docs: V1 product requirements draft (#10)
    * docs: add V1 product requirements draft; fix T2.3 mic pin order
    * docs(prd): fold in the open questions from Zero's review
    * docs(prd): record Ryan's answers as requirements; keep only open questions
    * docs(prd): list Zero's proposed values separately from confirmed requirements
    * docs(prd): add Ryan's battery targets; clarify hotspot and BLE pass criteria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
    [main.cpp, pins.h]
2026-10-19 docs(tasks,prd): log SGM40567 BAT+ & D4 switch-off bench measurement in T2.8/T6.1 (#52)
2026-10-20 feat(firmware,docs): add self_test Wi-Fi RSSI desense check and assembly routing rules (#53)
2026-10-20 feat(firmware,backend): add V1 All-Day Journal mode (journal_mode) and BLE WiFi_OFF low-power state (#54)
2026-10-20 docs(tasks,prd): log V2.5 48x33mm JLCPCB SMD Module-on-Carrier PCB (Issue #57) (#58)
2026-10-20 docs(tasks,prd): log V2.6 hybrid metal-rail + translucent resin + bare e-paper roadmap (Issue #59) (#60)
2026-10-20 feat(backend): wire Whisper STT, agy subscription brain, and Schedar Gemini/Kokoro TTS (Closes #40) (#61)
2026-10-20 fix(firmware): move s_wifi_disabled_for_ble_lp and ScopedCpuBoost declarations above handleJsonRpc (#62)
    [main.cpp]
2026-10-20 feat(android): skin Gotchi Pocket Emulator with Arctic Purple V2.6 chassis and hamburger settings (#74)
2026-10-21 feat(voice): harden roaming write-stall/abort, 100Hz HPF + 20ms frame RMS gate, and per-node TurnTranscriptSink handoff (#75)
    [audio_hal.cpp, voice_client.cpp]
2026-10-21 feat(voice): bundle Silero v5 silero_vad.onnx, add onnxruntime to pyproject.toml, and feed 64-sample context window (#77)
2026-10-21 fix(ble): carry GAD1 ADPCM state, guard SSE/4xx spooling, and harden BLE-to-WiFi speaker failover (#79)
    [BleFramingCodec.kt, ble_framing.h, voice_client.cpp]
2026-10-23 feat(cad): V3.2 snug tenon/hinge press-fit, decoupled button cradles, 3-slot gabled speaker grille & isolated plate layout
    [gotchi_back.stl, gotchi_button_cap.stl, gotchi_clip.stl, gotchi_clip_stand.stl, gotchi_front.stl, gotchi_hinge_saddle.stl, gotchi_kickstand.stl]
2026-10-23 feat(cad): Gotchi V4 (Rev 8.0) Option 1A top-wall USB-C, 18.3mm slim depth, V3.2 snug clip & 4-part buttonless plate
    [gotchi_back.stl, gotchi_clip_stand.stl, gotchi_front.stl, gotchi_hinge_saddle.stl]
2026-10-23 feat(cad): add bottom FPC ribbon relief pocket matching V2.1 display orientation
    [gotchi_front.stl]
2026-10-23 feat(cad): Gotchi V4.1 (Rev 8.1) clipped 8-pin header, 41mm battery bay, front-chin speaker grille & 1.8mm slim hinge boss
    [gotchi_back.stl, gotchi_clip_stand.stl, gotchi_front.stl, gotchi_hinge_saddle.stl]
2026-10-23 fix(cad): raise USB-C stadium cutout +1.05mm (z=-14.25mm) to match top-mounted XIAO receptacle above 1.25mm PCB
    [gotchi_back.stl, gotchi_clip_stand.stl, gotchi_front.stl, gotchi_hinge_saddle.stl]
2026-10-23 fix(cad): add +0.15mm Y-buffer to XIAO ESP32S3 well (24.85mm total Y span, y=+6.25..+31.10mm)
    [gotchi_back.stl, gotchi_clip_stand.stl, gotchi_hinge_saddle.stl]
2026-10-24 feat(cad): Gotchi V4.3 (Rev 8.4) validated button, switch, and 1510 speaker cradles with wire exit channels
    [gotchi_back.stl, gotchi_clip_stand.stl, gotchi_front.stl, gotchi_hinge_saddle.stl]
